earlvanze/Arduino-RFID-Door-Lock/README.md

# Arduino-RFID-Door-Lock
RFID Door Lock based on http://www.instructables.com/id/Arduino-RFID-Door-Lock/
